EmbeddedDesign/VehicleAccessoryController/hardware/VehicleAccessoryController/img/IMG_5393.jpg

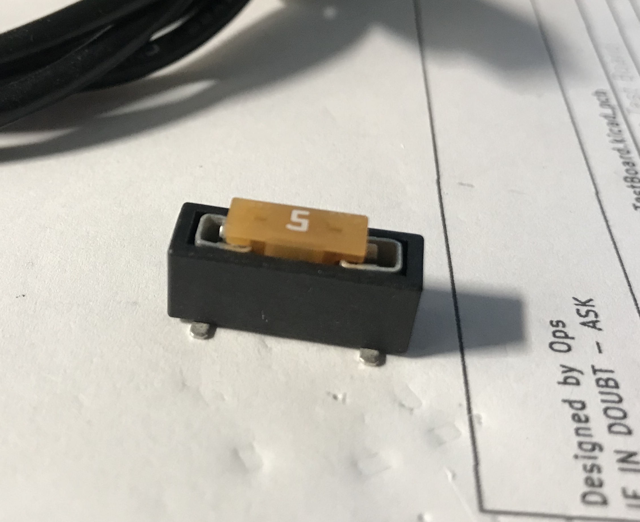
hardware/VehicleAccessoryController/img/IMG_5393.jpg
