EmbeddedDesign/VehicleAccessoryController/hardware/VehicleAccessoryController/img/VehicleAccessoryController_CAD.png

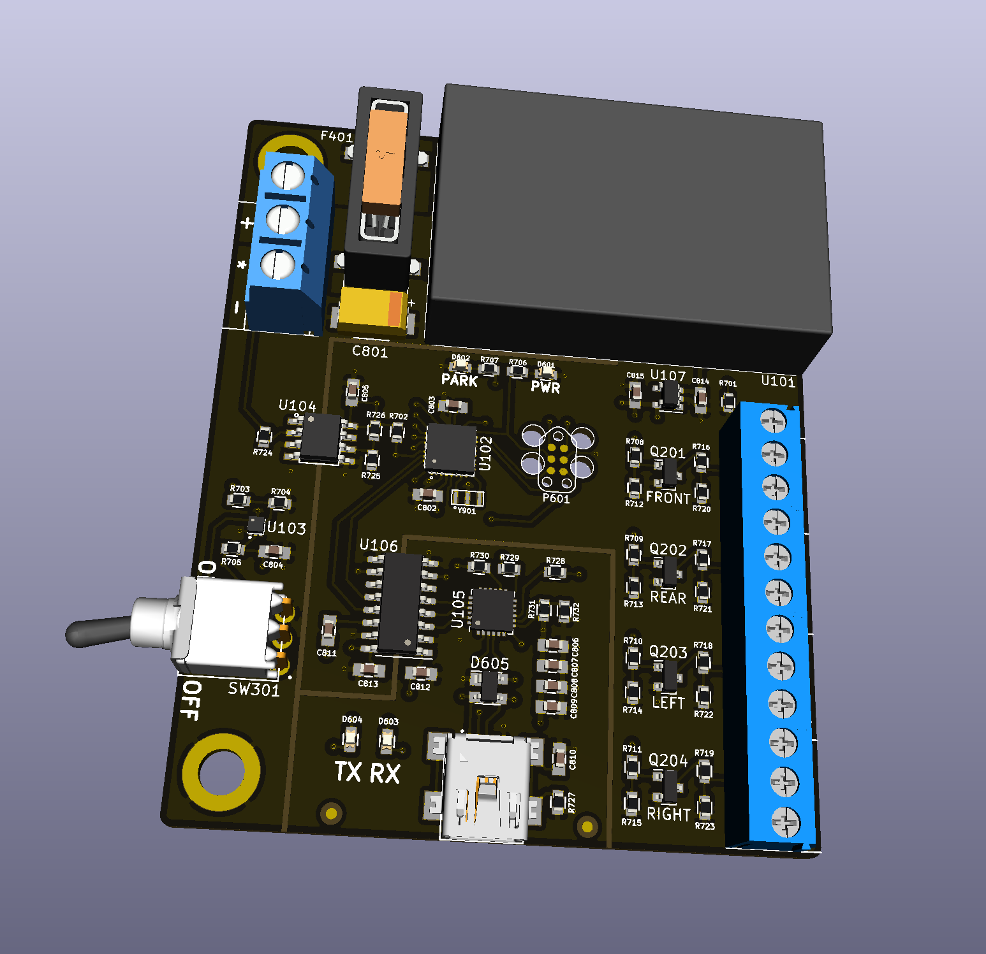
hardware/VehicleAccessoryController/img/VehicleAccessoryController_CAD.png
