EmbeddedDesign/VehicleAccessoryController/README.md

# VehicleAccessoryController
Vehicle Dash Cam and Accessory Controller
