EmbeddedDesign/VehicleAccessoryController/Garmin/IMG_5390.jpg

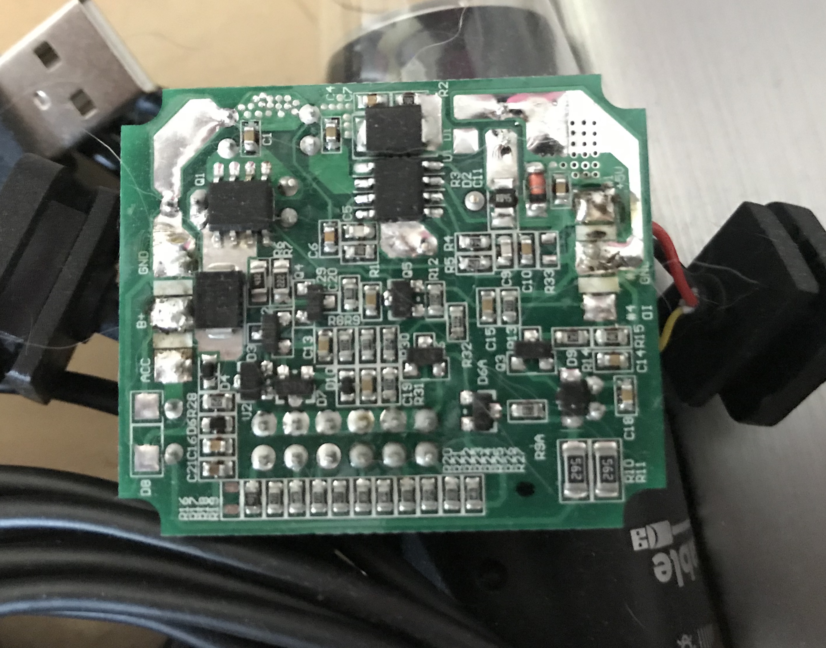
Garmin/IMG_5390.jpg
