EmbeddedDesign/VehicleAccessoryController/Garmin/IMG_5391.jpg

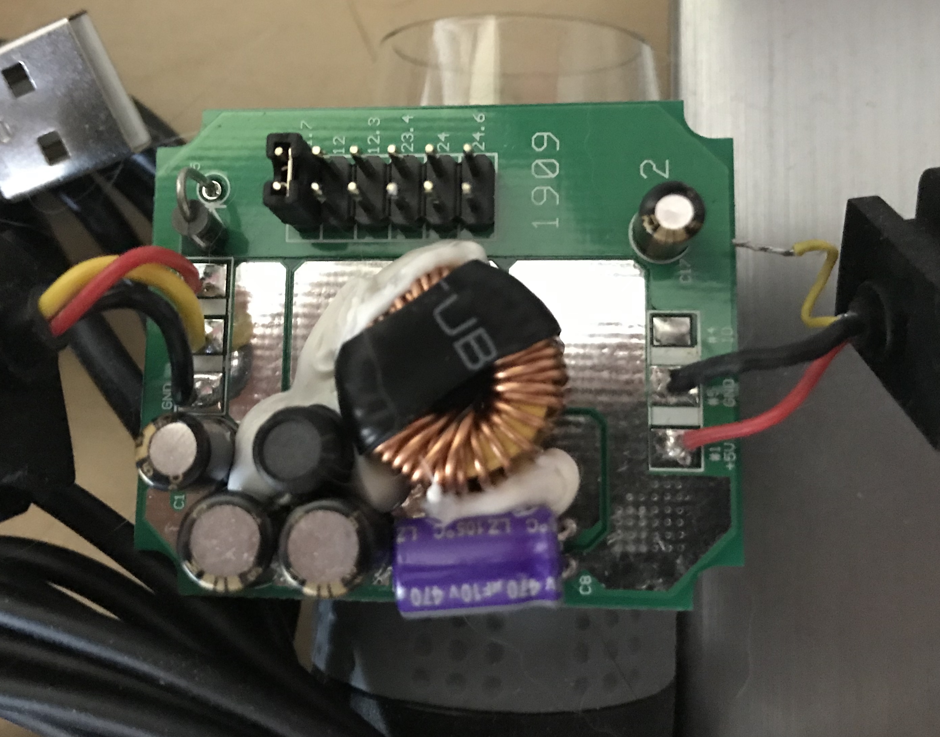
Garmin/IMG_5391.jpg
