EmbeddedDesign/VehicleAccessoryController/Garmin/Parking_Mode_IC1.jpg

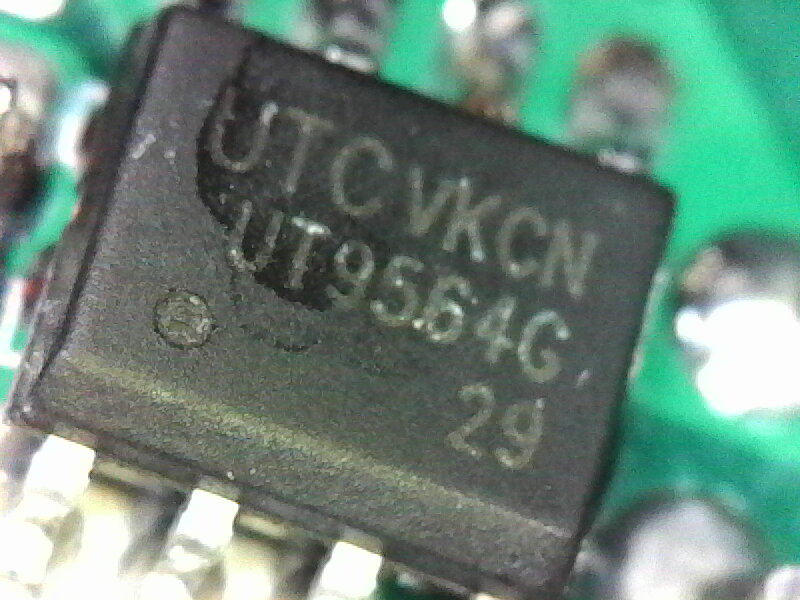
Garmin/Parking_Mode_IC1.jpg
