EmbeddedDesign/VehicleAccessoryController/Garmin/Parking_Mode_IC2.jpg

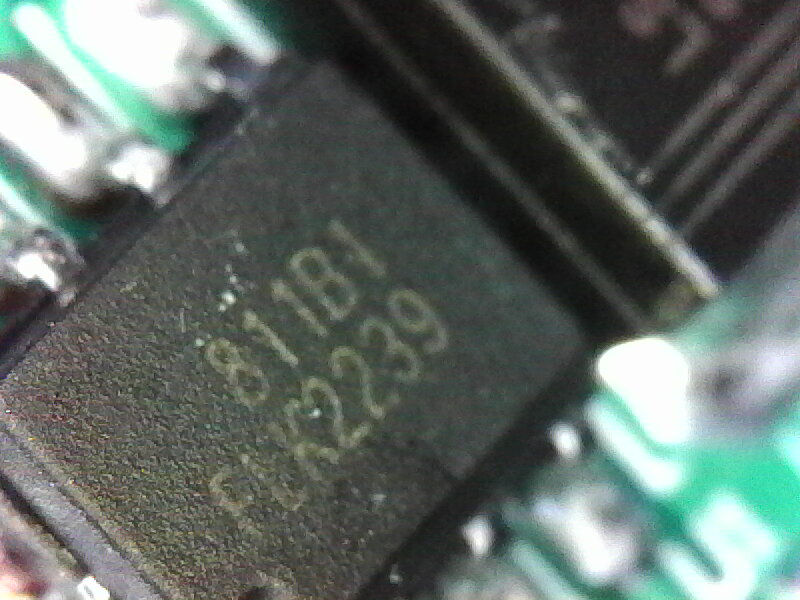
Garmin/Parking_Mode_IC2.jpg
