EmbeddedDesign/VehicleAccessoryController/Garmin/Parking_Mode_IDPIN1.jpg

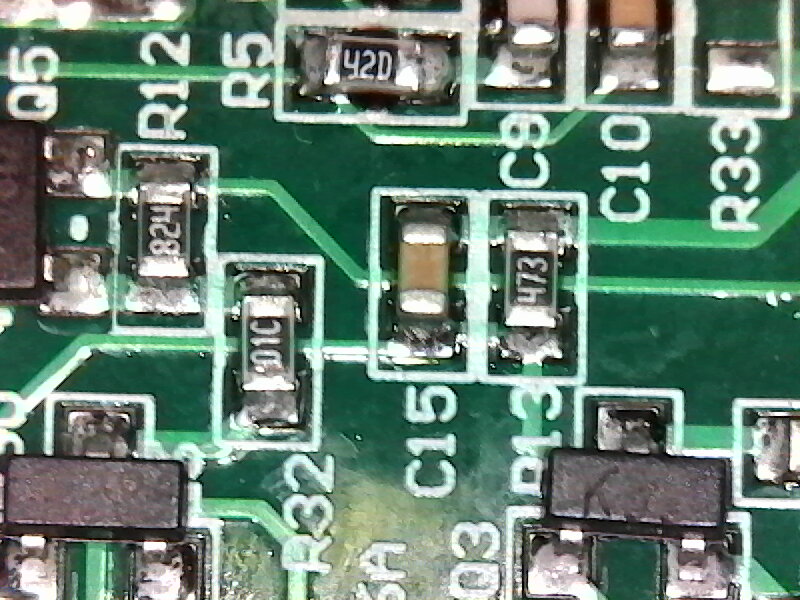
Garmin/Parking_Mode_IDPIN1.jpg
