EmbeddedDesign/VehicleAccessoryController/Garmin/Parking_Mode_IDPIN2.jpg

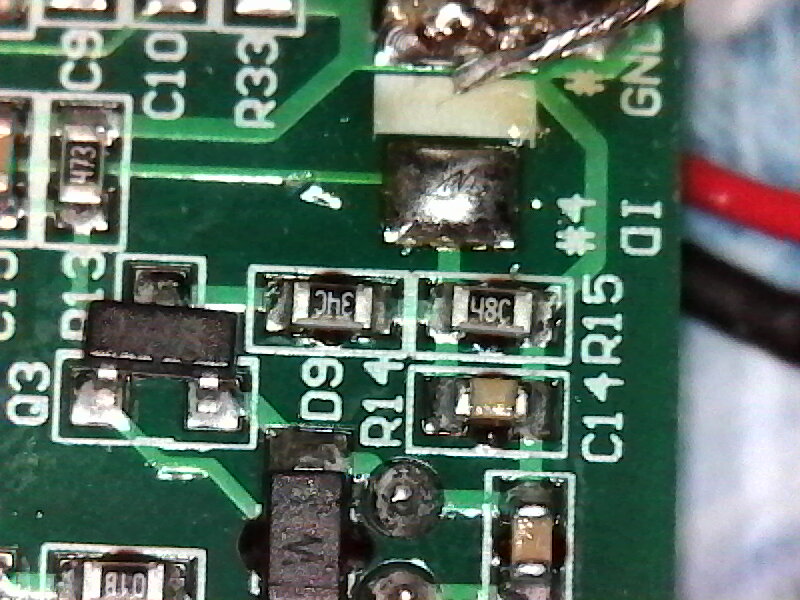
Garmin/Parking_Mode_IDPIN2.jpg
