EmbeddedDesign/VehicleAccessoryController/Garmin/XRAY_center.png

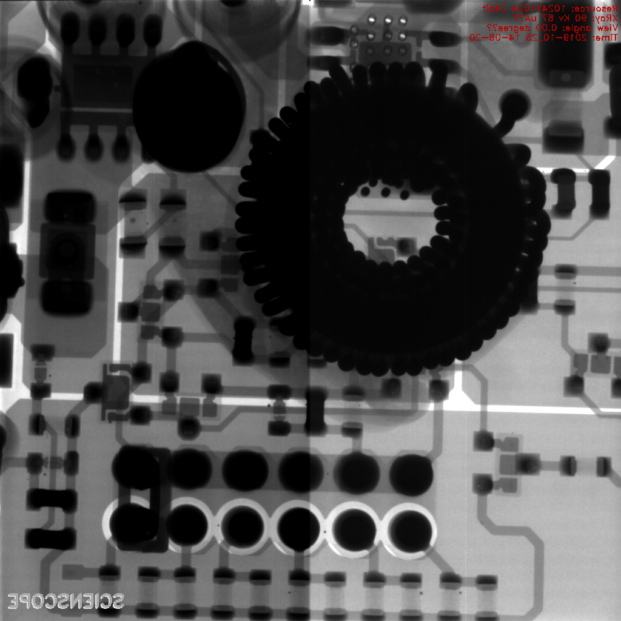
Garmin/XRAY_center.png
