EmbeddedDesign/VehicleAccessoryController/Garmin/XRAY_lower_left.png

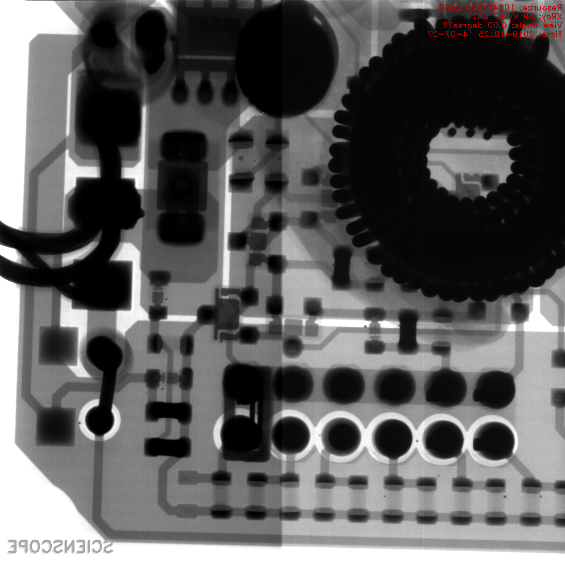
Garmin/XRAY_lower_left.png
