EmbeddedDesign/VehicleAccessoryController/Garmin/XRAY_lower_right.png

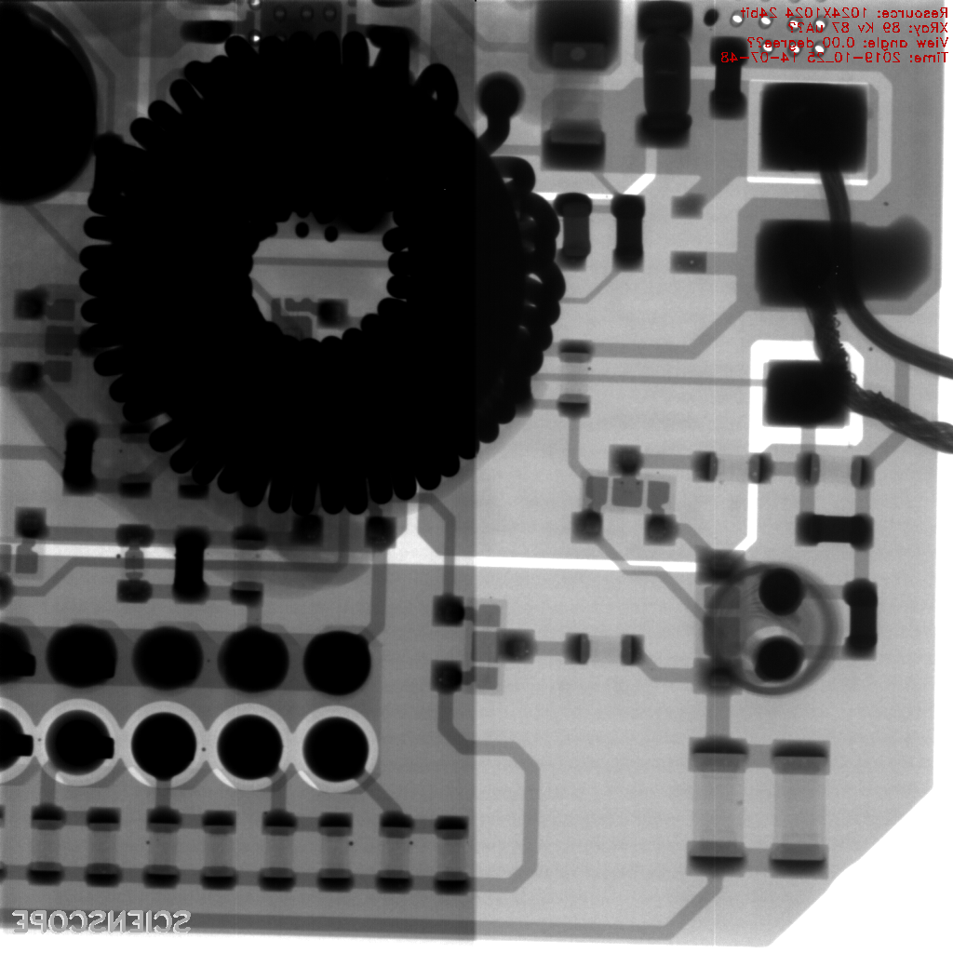
Garmin/XRAY_lower_right.png
