EmbeddedDesign/VehicleAccessoryController/Garmin/XRAY_upper_left.png

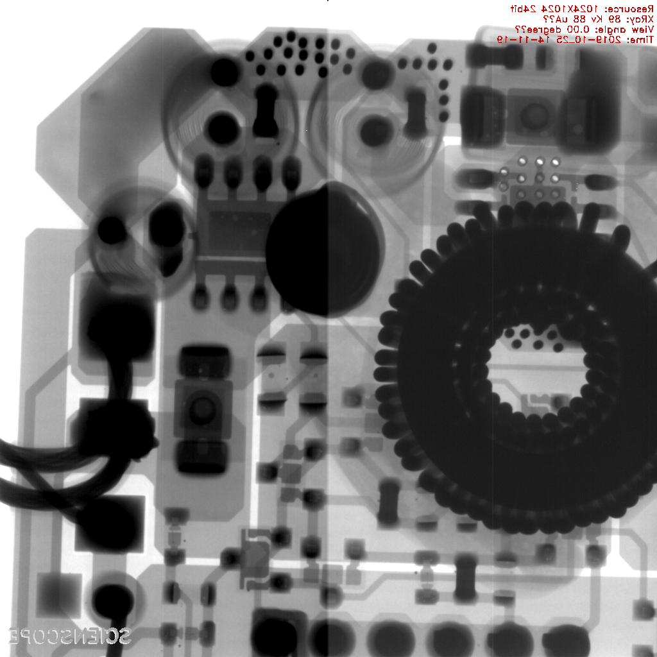
Garmin/XRAY_upper_left.png
