EmbeddedDesign/VehicleAccessoryController/Garmin/XRAY_upper_right.png

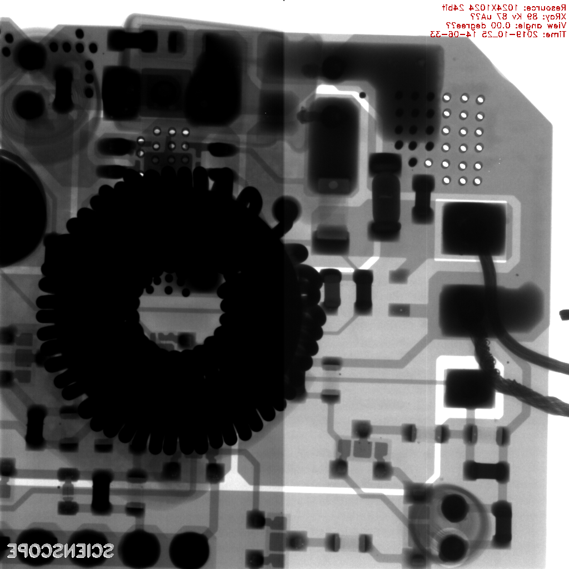
Garmin/XRAY_upper_right.png
