EmbeddedDesign/VehicleAccessoryController/hardware/VehicleAccessoryController/img/IMG_5392.jpg

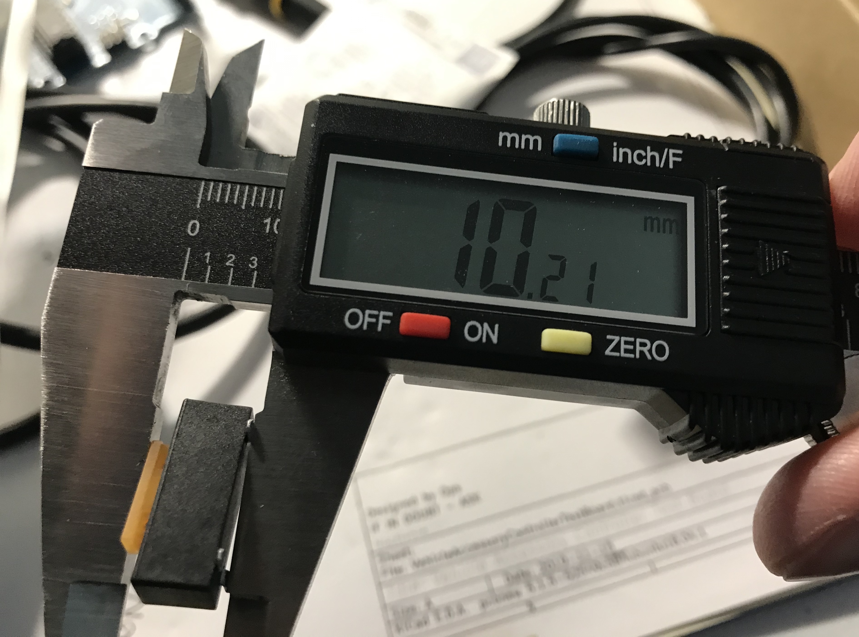
hardware/VehicleAccessoryController/img/IMG_5392.jpg
