EmbeddedDesign/VehicleAccessoryController/img/IMG_5389.jpg

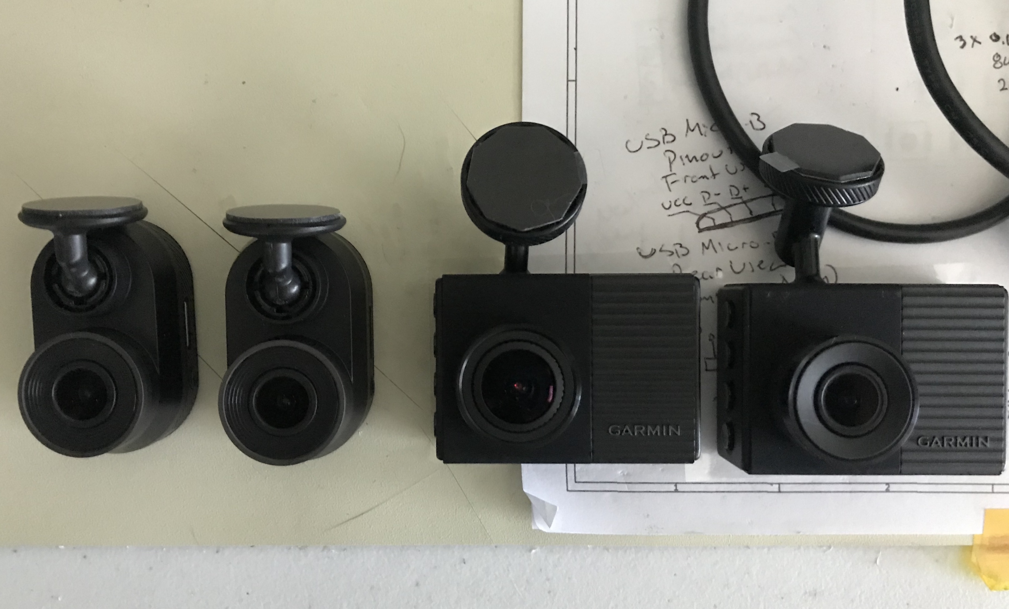
img/IMG_5389.jpg
