EmbeddedDesign/VehicleAccessoryController/hardware/VehicleAccessoryController/VehicleAccessoryController_BOM.ods

Sheet: Vehicle Accessory Controller PCBA
Vehicle Accessory Controller PCBA BOM v1.0
REF | QTY | Cost | MRF | MFRPN | DESCRIPTION | PACKAGE | DATASHEET | LINK | ALT
U101 | 1 | $78.25 | Recom | REM20-2405SW/P | Recom Power Module, Control Pin Positive Logic | Custom | https://recom-power.com/pdf/Medline_DC-DC/REM20-W.pdf | https://www.arrow.com/en/products/rem20-2405swp/recom-power
U102 | 1 | $2.24 | Atmel | ATMEGA328P-MNR | ATmega328P | 32-VQFN/MLF | http://ww1.microchip.com/downloads/en/DeviceDoc/ATmega48A-PA-88A-PA-168A-PA-328-P-DS-DS40002061A.pdf | https://www.arrow.com/en/products/atmega328p-mnr/microchip-technology
U103 | 1 | $1.66 | TI | TPS3710QDSERQ1 | Under-voltage Supervisor | WSON-6 | https://www.ti.com/lit/ds/symlink/tps3710-q1.pdf | https://www.arrow.com/en/products/tps3710qdserq1/texas-instruments
U104 | 1 | $0.79 | SiLabs | SI8710CC-B-IS | Single-Channel Digital Isolator | SOIC-8 NB | https://media.digikey.com/pdf/Data Sheets/Silicon Laboratories PDFs/Si87xx.pdf (https://media.digikey.com/pdf/Data%20Sheets/Silicon%20Laboratories%20PDFs/Si87xx.pdf) | https://www.arrow.com/en/products/si8710cc-b-is/silicon-labs
U105 | 1 | $1.33 | SiLabs | CP2102N-A02-GQFN24 | USB-to-UART Bridge | QFN24 | https://www.silabs.com/documents/public/data-sheets/cp2102n-datasheet.pdf | https://www.arrow.com/en/products/cp2102n-a02-gqfn24/silicon-labs
U106 | 1 | $2.58 | SiLabs | Si8631EC-B-IS1 | Tripple-Channel Digital Isolator, Default High | NB SOIC-16 | https://www.silabs.com/documents/public/data-sheets/si863x-datasheet.pdf | https://www.arrow.com/en/products/si8631ec-b-is1/silicon-labs
U107 | 1 | $0.58 | ON Semi | NCV551SN50T1G | LDO, 5V, 150mA | SOT-23-5 | https://www.onsemi.com/pub/Collateral/NCP551-D.PDF | https://www.arrow.com/en/products/ncv551sn50t1g/on-semiconductor
Y901 | 1 | $0.40 | Murata | CSTNE16M0VH3C000R0 | 16MHz Resonator, 0.13%, 15pF | 3 Pad Custom | https://www.murata.com/en/products/productdata/8801162264606/SPEC-CSTNE16M0VH3C000R0.pdf | https://www.arrow.com/en/products/cstne16m0vh3c000r0/murata-manufacturing
Q201, Q202, Q203, Q204 | 4 | $0.22 | ON Semi | BSS138 | N-Channel Logic-Level Enhancement Mode MOSFET | SOT-23-3 | https://www.onsemi.com/pub/Collateral/BSS138-D.PDF | https://www.arrow.com/en/products/bss138/on-semiconductor | Diodes BSN20-7
D601, D602, D603, D604 | 4 | $0.41 | OSRAM | LB Q39G-L2OO-35-1 | Indicator LED, Blue, 2.85Vf | Chip 0603 | https://media.digikey.com/pdf/Data Sheets/Osram PDFs/LB_Q39G_v1.4_9-1-15.pdf (https://media.digikey.com/pdf/Data%20Sheets/Osram%20PDFs/LB_Q39G_v1.4_9-1-15.pdf) | https://www.arrow.com/en/products/lbq39g-l2oo-35-1/osram-opto-semiconductors
D605 | 1 | $0.70 | Littelfuse | SP0503BAHT | 3-Channel TVS Diode Array | SOT143 | https://www.littelfuse.com/~/media/files/littelfuse/technical resources/documents/data sheets/sp05xxba.pdf | https://www.arrow.com/en/products/sp0503bahtg/littelfuse
SW301 | 1 | $6.74 | C&K | ET01MD1AGE | SPDT On-On Toggle Switch | Custom | https://www.ckswitches.com/products/toggle/ET/#ET01MD1AGE | https://www.arrow.com/en/products/et01md1age/ck | C&K ET01MD1ABE, C&K ET01M3D1ABE (Black ESD)
F401 | 1 | $1.53 | Keystone | 3587 | Low Profile MINI Fuse Holder | Custom | http://www.keyelco.com/product-pdf.cfm?p=310 | https://www.digikey.com/product-detail/en/keystone-electronics/3587/36-3587-ND/2137315 | 3587-10 (Red), 3587-15 (Blue), 3587-20 (Yellow)
J501 | 1 | $1.16 | Keystone | 8719 | 1x3 Screw Terminal 14-22 AWG | Custom | https://www.keyelco.com/userAssets/file/M55p58.pdf | https://www.digikey.com/product-detail/en/keystone-electronics/8719/36-8719-ND/317125
J502, J503, J504, J505 | 4 | $1.01 | TE | 1776275-3 | 1x3 Screw Terminal 18-26 AWG | Custom | https://www.te.com/commerce/DocumentDelivery/DDEController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 | https://www.arrow.com/en/products/1776275-3/te-connectivity
J506 | 1 | $0.77 | AFCI | 10033526-N3212LF | USB-mini Connector | Custom | https://www.amphenol-icc.com/media/wysiwyg/files/drawing/10033526.pdf | https://www.arrow.com/en/products/10033526-n3212lf/amphenol-fci | 10033526-N3212MLF, 10033526-N3222LF, 10033526-N3222MLF
R701 | 1 | $0.33 | Panasonic | ERA-3AEB4872V | 48.7K Ohm Resistor, +/-1%, 1/16W or greater | 0603 | https://industrial.panasonic.com/cdbs/www-data/pdf/RDM0000/AOA0000C307.pdf | https://www.arrow.com/en/products/era-3aeb4872v/panasonic
R702 | 1 | $0.65 | Panasonic | ERA-3APB103V | 10K Ohm Resistor, +/-5%, 0.1W | 0603 | https://industrial.panasonic.com/cdbs/www-data/pdf/RDM0000/AOA0000C307.pdf | https://www.arrow.com/en/products/era-3apb103v/panasonic
R703 | 1 | $0.10 | Yageo | RC0603FR-072M43L | 2.43M Ohm Resistor, +/-0.5%, 0.1W | 0603 | https://static6.arrow.com/aropdfconversion/ab27cab4c33d97da38ecc8ac38e34caed1b4f994/rc0603fr-07956kl.pdf | https://www.arrow.com/en/products/rc0603fr-072m43l/yageo
R704 | 1 | $0.33 | Panasonic | ERA-3AEB8452V | 84.5K Ohm Resistor, +/-0.5%, 0.1W | 0603 | https://industrial.panasonic.com/cdbs/www-data/pdf/RDM0000/AOA0000C307.pdf | https://www.arrow.com/en/products/era-3aeb8452v/panasonic
R705 | 1 | $0.54 | Panasonic | ERA-3ARB4992V | 49.9K Ohm Resistor, +/-0.5%, 0.1W | 0603 | https://industrial.panasonic.com/cdbs/www-data/pdf/RDM0000/AOA0000C307.pdf | https://www.arrow.com/en/products/era-3arb4992v/panasonic
R706, R707 | 2 | $0.33 | Panasonic | ERA-3AEB431V | 430 Ohm Led Resistor, +/-5%, 0.1W | 0603 | https://industrial.panasonic.com/cdbs/www-data/pdf/RDM0000/AOA0000C307.pdf | https://www.arrow.com/en/products/era3aeb431v/panasonic
R725 | 1 | $0.33 | Panasonic | ERA-3AED161V | 160 Ohm Resistor, +/-5%, 0.1W | 0603 | https://industrial.panasonic.com/cdbs/www-data/pdf/RDM0000/AOA0000C307.pdf | https://www.arrow.com/en/products/era-3aeb161v/panasonic
R708, R709, R710, R711, R724, R726, R728 | 7 | $0.54 | Panasonic | ERA-3ARB102V | 1K Ohm Resistor, +/-5%, 0.1W | 0603 | https://industrial.panasonic.com/cdbs/www-data/pdf/RDM0000/AOA0000C307.pdf | https://www.arrow.com/en/products/search?cat=&q=ERA-3ARB102V&r=true
R712, R713, R714, R715, R727 | 5 | $0.14 | Panasonic | ERJ-PA3F1004V | 1M Ohm Resistor, +/-5%, 0.1W | 0603 | https://industrial.panasonic.com/cdbs/www-data/pdf/RDO0000/AOA0000C331.pdf | https://www.arrow.com/en/products/erj-pa3f1004v/panasonic
R716, R717, R718, R719, R731 | 5 | $0.33 | Panasonic | ERA-3AEB2212V | 22.1K Ohm Resistor, +/-1%, 0.1W | 0603 | https://industrial.panasonic.com/cdbs/www-data/pdf/RDM0000/AOA0000C307.pdf | https://www.arrow.com/en/products/era-3aeb2212v/panasonic
R720, R721, R722, R723 | 4 | $0.33 | Panasonic | ERA-3AEB3092V | 30.9K Ohm Resistor, +/-1%, 0.1W | 0603 | https://industrial.panasonic.com/cdbs/www-data/pdf/RDM0000/AOA0000C307.pdf | https://www.arrow.com/en/products/era-3aeb3092v/panasonic
R729, R730 | 2 | $0.33 | Panasonic | ERA-3AEB90R9V | 90.9 Ohm Led Resistor, +/-5%, 0.1W | 0603 | https://industrial.panasonic.com/cdbs/www-data/pdf/RDM0000/AOA0000C307.pdf | https://www.arrow.com/en/products/era-3aeb90r9v/panasonic
R732 | 1 | $0.33 | Panasonic | ERA-3AEB4752V | 47.5K Ohm Resistor, +/-1%, 0.1W | 0603 | https://industrial.panasonic.com/cdbs/www-data/pdf/RDM0000/AOA0000C307.pdf | https://www.arrow.com/en/products/era3aeb4752v/panasonic
C801 | 1 | $2.79 | Kemet | T498D106K050ATE1K0 | 10uF Capacitor, +/-10%, 50V, X7R | 2917 | https://content.kemet.com/datasheets/KEM_T2053_T498_AUTO.pdf | https://www.arrow.com/en/products/t498d106k050ate1k0/kemet-corporation
C802, C814, C815 | 3 | $0.27 | Murata | GCJ188R71E105KA01D | 1uF Capacitor, +/-10%, 16V, X7R | 0603 | https://search.murata.co.jp/Ceramy/image/img/A01X/G101/ENG/GCJ188R71E105KA01-01.pdf | https://www.arrow.com/en/products/gcj188r71e105ka01d/murata-manufacturing
C803, C804, C805, C807, C809, C811, C812, C813 | 8 | $0.09 | Murata | GCJ188R71E104KA12D | 0.1uF Capacitor, +/-10%, 16V, X7R | 0603 | https://search.murata.co.jp/Ceramy/image/img/A01X/G101/ENG/GCJ188R71E104KA12-01.pdf | https://www.arrow.com/en/products/gcj188r71e104ka12d/murata-manufacturing
C806, C808 | 2 | $0.38 | Murata | GRM188C71C475KE21D | 4.7uF Capacitor, +/-10%, 16V, X7R | 0603 | https://search.murata.co.jp/Ceramy/image/img/A01X/G101/ENG/GRM188C71C475KE21-01.pdf | https://www.arrow.com/en/products/grm188c71c475ke21d/murata-manufacturing
C810 | 1 | $0.28 | Kemet | C0603C101K4RACAUTO | 0.1nF Capacitor, +/-10%, 16V, X7R | 0603 | https://content.kemet.com/datasheets/KEM_C1023_X7R_AUTO_SMD.pdf | https://www.arrow.com/en/products/c0603c101k4racauto/kemet-corporation
 | Cost/Board: | $122.03

Sheet: Other
Vehicle Accessory Controller Other v1.0
QTY | Cost | MRF | MFRPN | DESCRIPTION | DATASHEET | LINK | ALT
1 | $0.36 | C&K | 706202000 | Toggle Switch Cap | https://www.ckswitches.com/products/toggle/ET/ | https://www.arrow.com/en/products/706202000/ck
4 | $0.95 | Adafruit | 1826 | Micro USB Connector Solderable | https://media.digikey.com/pdf/Data Sheets/Adafruit PDFs/1826_Web.pdf (https://media.digikey.com/pdf/Data%20Sheets/Adafruit%20PDFs/1826_Web.pdf) | https://www.arrow.com/en/products/1826/adafruit-industries
1 | $0.37 | Littelfuse | 0891005.NXS | Low Profile MINI Blade Fuse, 5A, Tan | https://www.littelfuse.com/~/media/automotive/datasheets/fuses/passenger-car-and-commercial-vehicle/blade-fuses/littelfuse_lowprofilemini_datasheet.pdf | https://www.digikey.com/products/en?keywords= 0891005.NXS | 0891005.H, 0891005.U
1 | $0.37 | Littelfuse | 0891002.NXS | Low Profile MINI Blade Fuse, 2A, Gray | https://www.littelfuse.com/~/media/automotive/datasheets/fuses/passenger-car-and-commercial-vehicle/blade-fuses/littelfuse_lowprofilemini_datasheet.pdf | https://www.digikey.com/product-detail/en/littelfuse-inc/0891002-NXS/F5926-ND/2046664
1 | $0.80 | Littelfuse | 00970021HXNVDL | Fuse Puller | https://www.littelfuse.com/~/media/automotive/datasheets/fuse-pullers/littelfuse_fuse_puller_tester.pdf | https://www.digikey.com/product-detail/en/littelfuse-inc/00970021HXNVDL/F6036-ND/3425337
1 | $117.80 | Tensility | 30-00496 | 3 Conductor 26 AWG Cable | https://tensility.s3.amazonaws.com/uploads/pdffiles/30-00496.pdf?X-Amz-Expires=600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 | https://www.digikey.com/products/en/cables-wires/multiple-conductor-cables/473?k=30-00496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
1 | $15.20 | Remington | 16STRBLAGXL25 | 1 Conductor, 16AWG, Automotive Cable, Black | https://media.digikey.com/pdf/Data Sheets/RemingtonInd/GXL_Hook_Up_Wire_DataSheet.pdf (https://media.digikey.com/pdf/Data%20Sheets/RemingtonInd/GXL_Hook_Up_Wire_DataSheet.pdf) | https://www.digikey.com/product-detail/en/remington-industries/16STRBLAGXL25/2328-16STRBLAGXL25-ND/12318330
1 | $15.20 | Remington | 16STRREDGXL25 | 1 Conductor, 16AWG, Automotive Cable, Red | https://media.digikey.com/pdf/Data Sheets/RemingtonInd/GXL_Hook_Up_Wire_DataSheet.pdf (https://media.digikey.com/pdf/Data%20Sheets/RemingtonInd/GXL_Hook_Up_Wire_DataSheet.pdf) | https://www.digikey.com/product-detail/en/remington-industries/16STRREDGXL25/2328-16STRREDGXL25-ND/12318290
1 | $5.42 | Kemet | EFW(005)-80X80T0800 | RF EMI Absorbing Sheet, 80mm x 80mm | https://content.kemet.com/datasheets/KEM_FS8004_NSS.pdf | https://www.digikey.com/product-detail/en/kemet/EFW-005-80X80T0800/399-EFW-005-80X80T0800-ND/11503822
1 | $0.35 | TE | 320560 | Ring Terminal, 14-16 AWG, #8 Stud | https://www.te.com/commerce/DocumentDelivery/DDEController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 | https://www.digikey.com/product-detail/en/te-connectivity-amp-connectors/320560/A27256-ND/299296
Cost/Board: | $159.67
