EmbeddedDesign/VehicleAccessoryController/hardware/VehicleAccessoryControllerTestBoard/img/IMG_5388.jpg

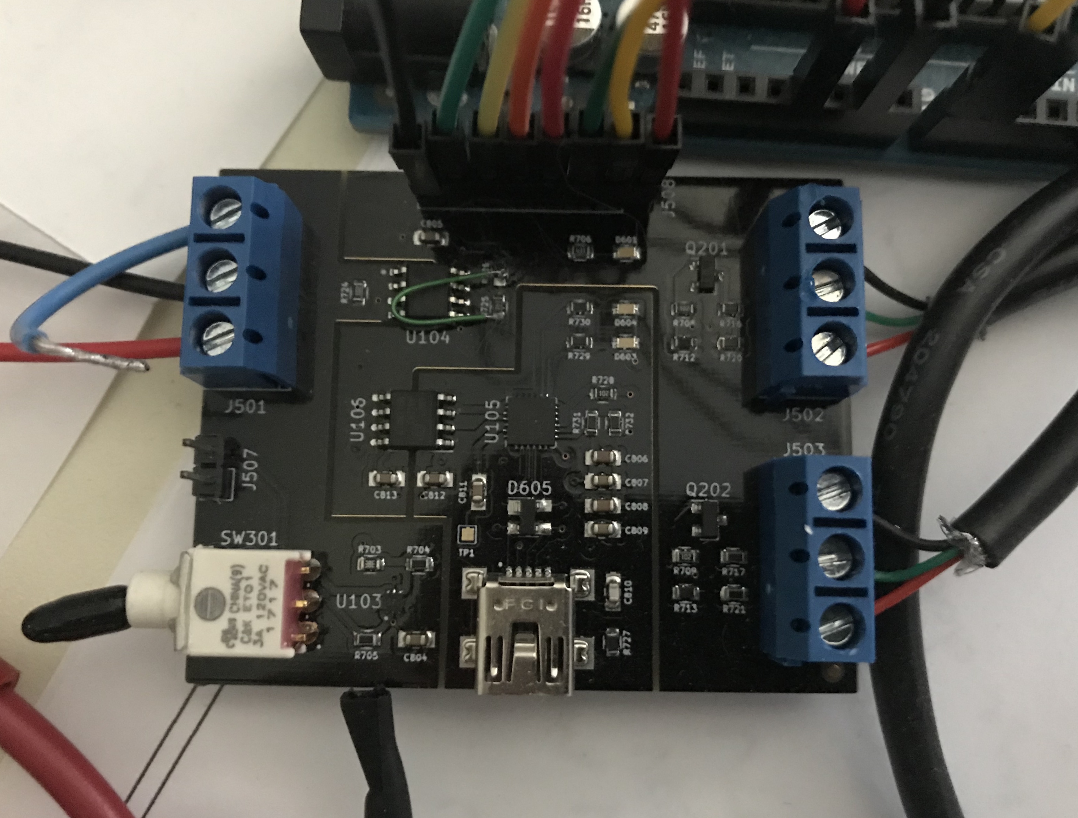
hardware/VehicleAccessoryControllerTestBoard/img/IMG_5388.jpg
