EmbeddedDesign/VehicleAccessoryController/hardware/VehicleAccessoryController/VehicleAccessoryController_schematic.pdf

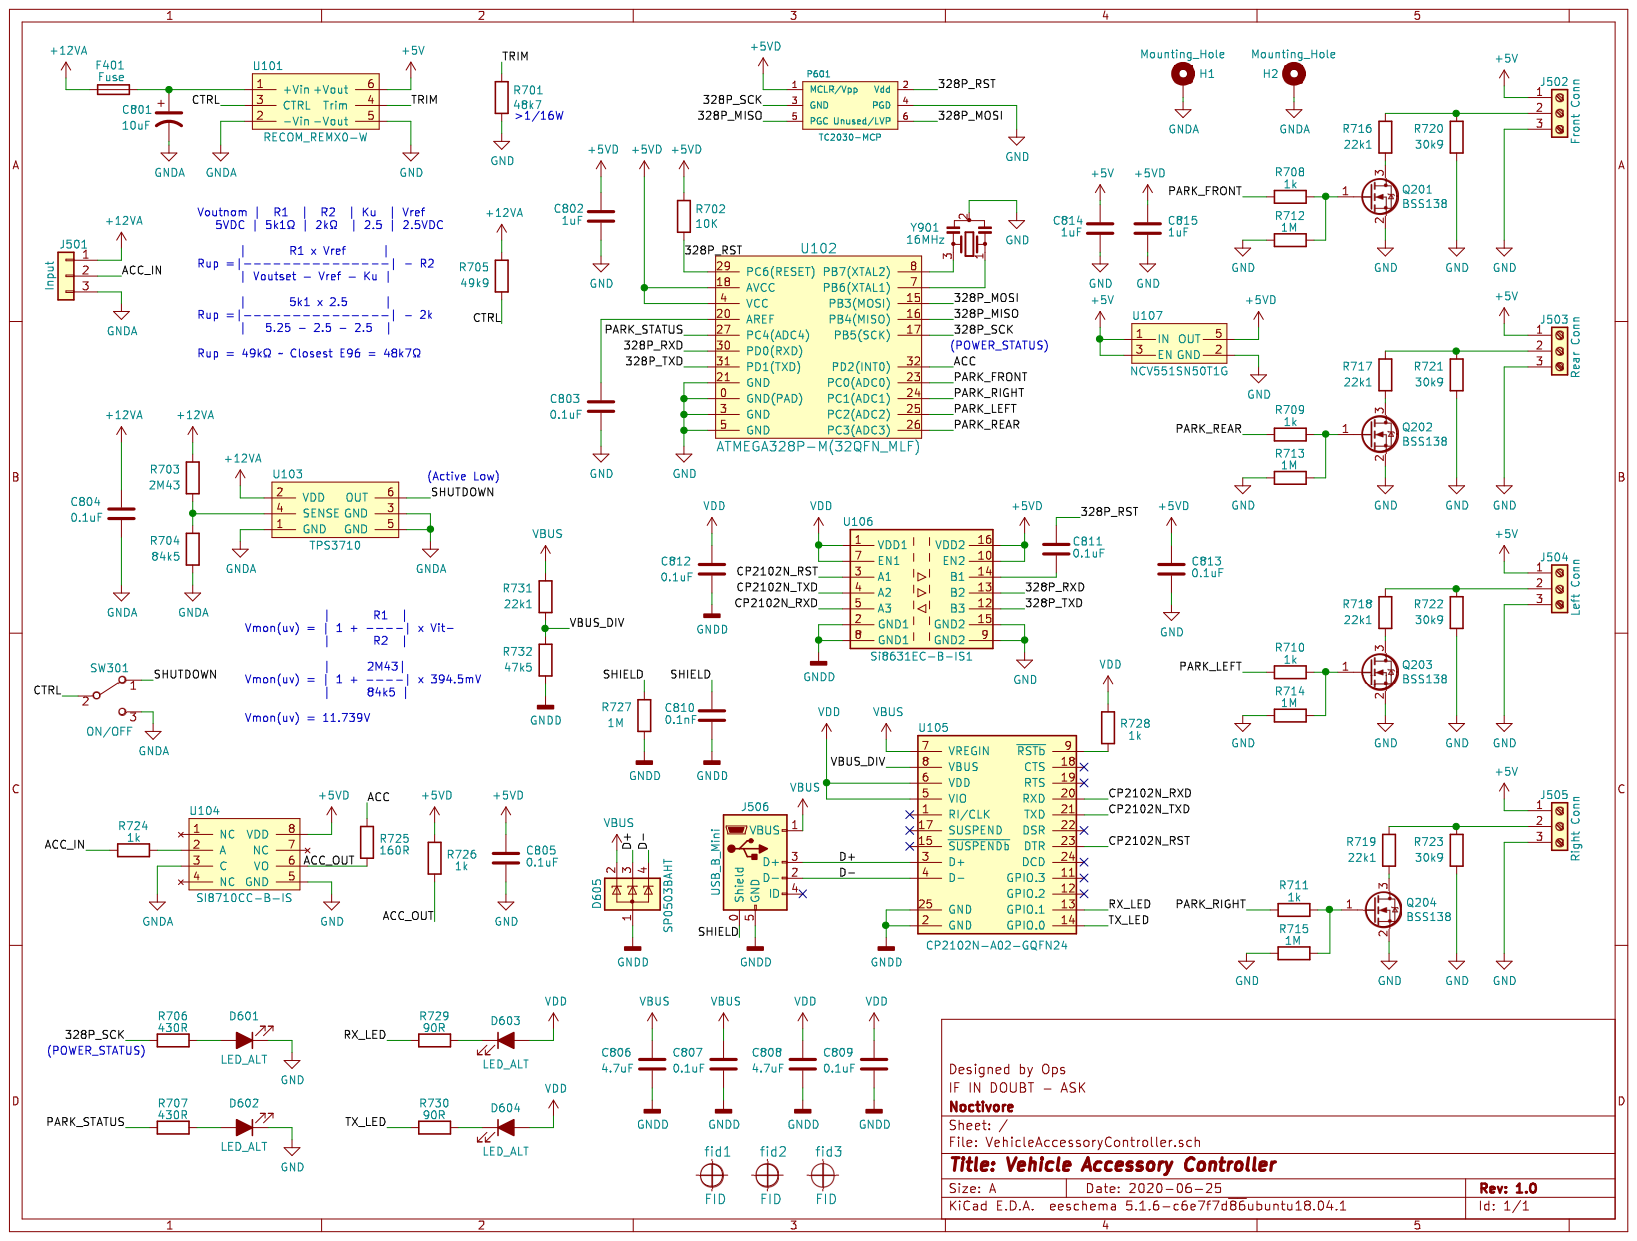
[picture p17: page 1]
