EmbeddedDesign/VehicleAccessoryController/hardware/VehicleAccessoryController/VehicleAccessoryController_layout.pdf

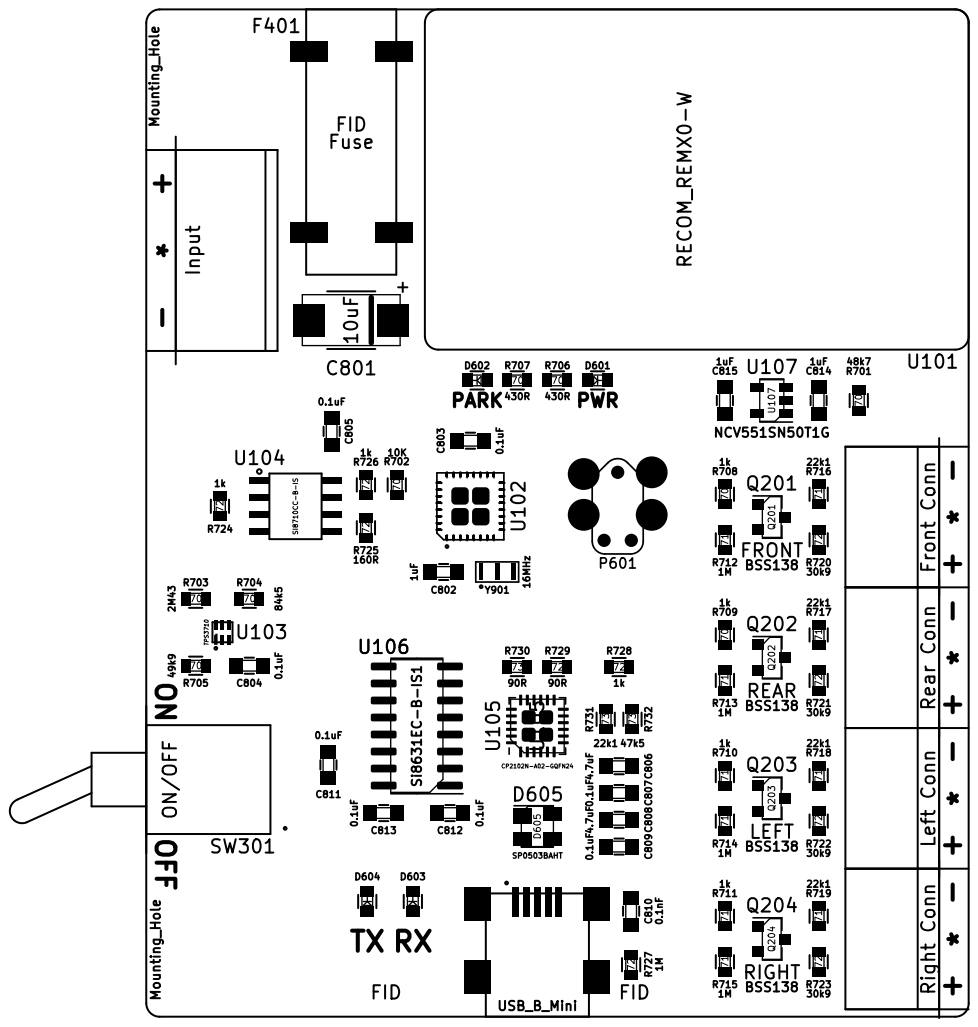
[picture p18: page 1]
