EmbeddedDesign/VehicleAccessoryController/hardware/VehicleAccessoryControllerTestBoard/VehicleAccessoryControllerTestBoard_Layout.pdf

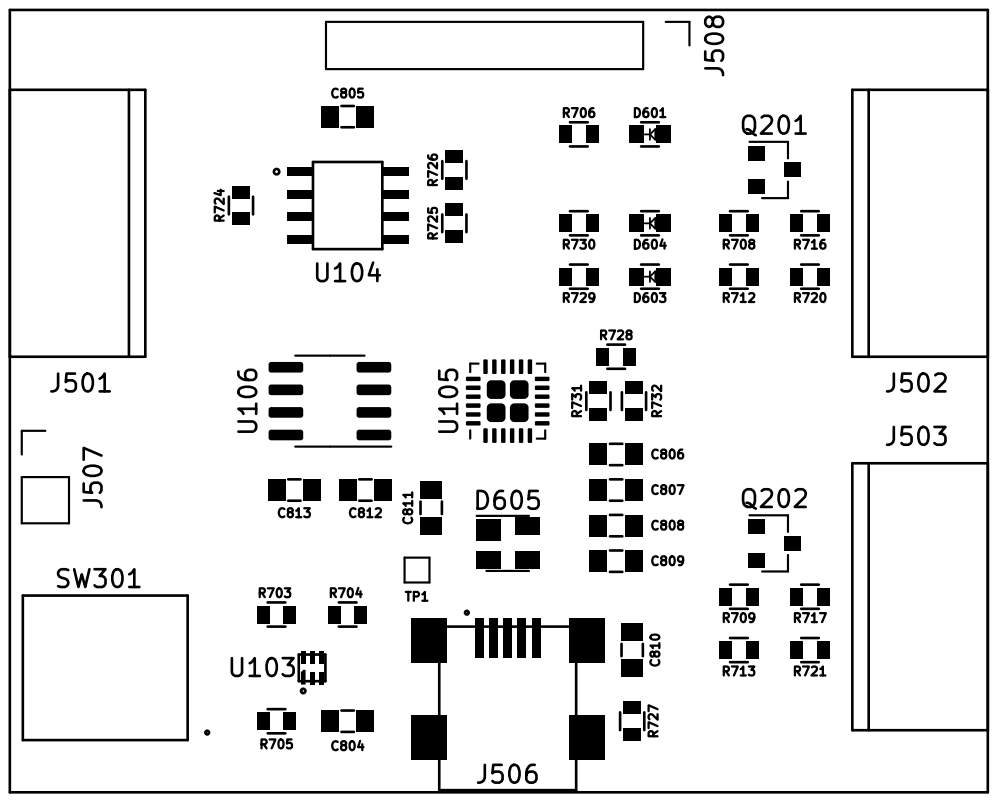
[picture p19: page 1]
