EmbeddedDesign/VehicleAccessoryController/hardware/VehicleAccessoryControllerTestBoard/VehicleAccessoryControllerTestBoard_Schematic.pdf

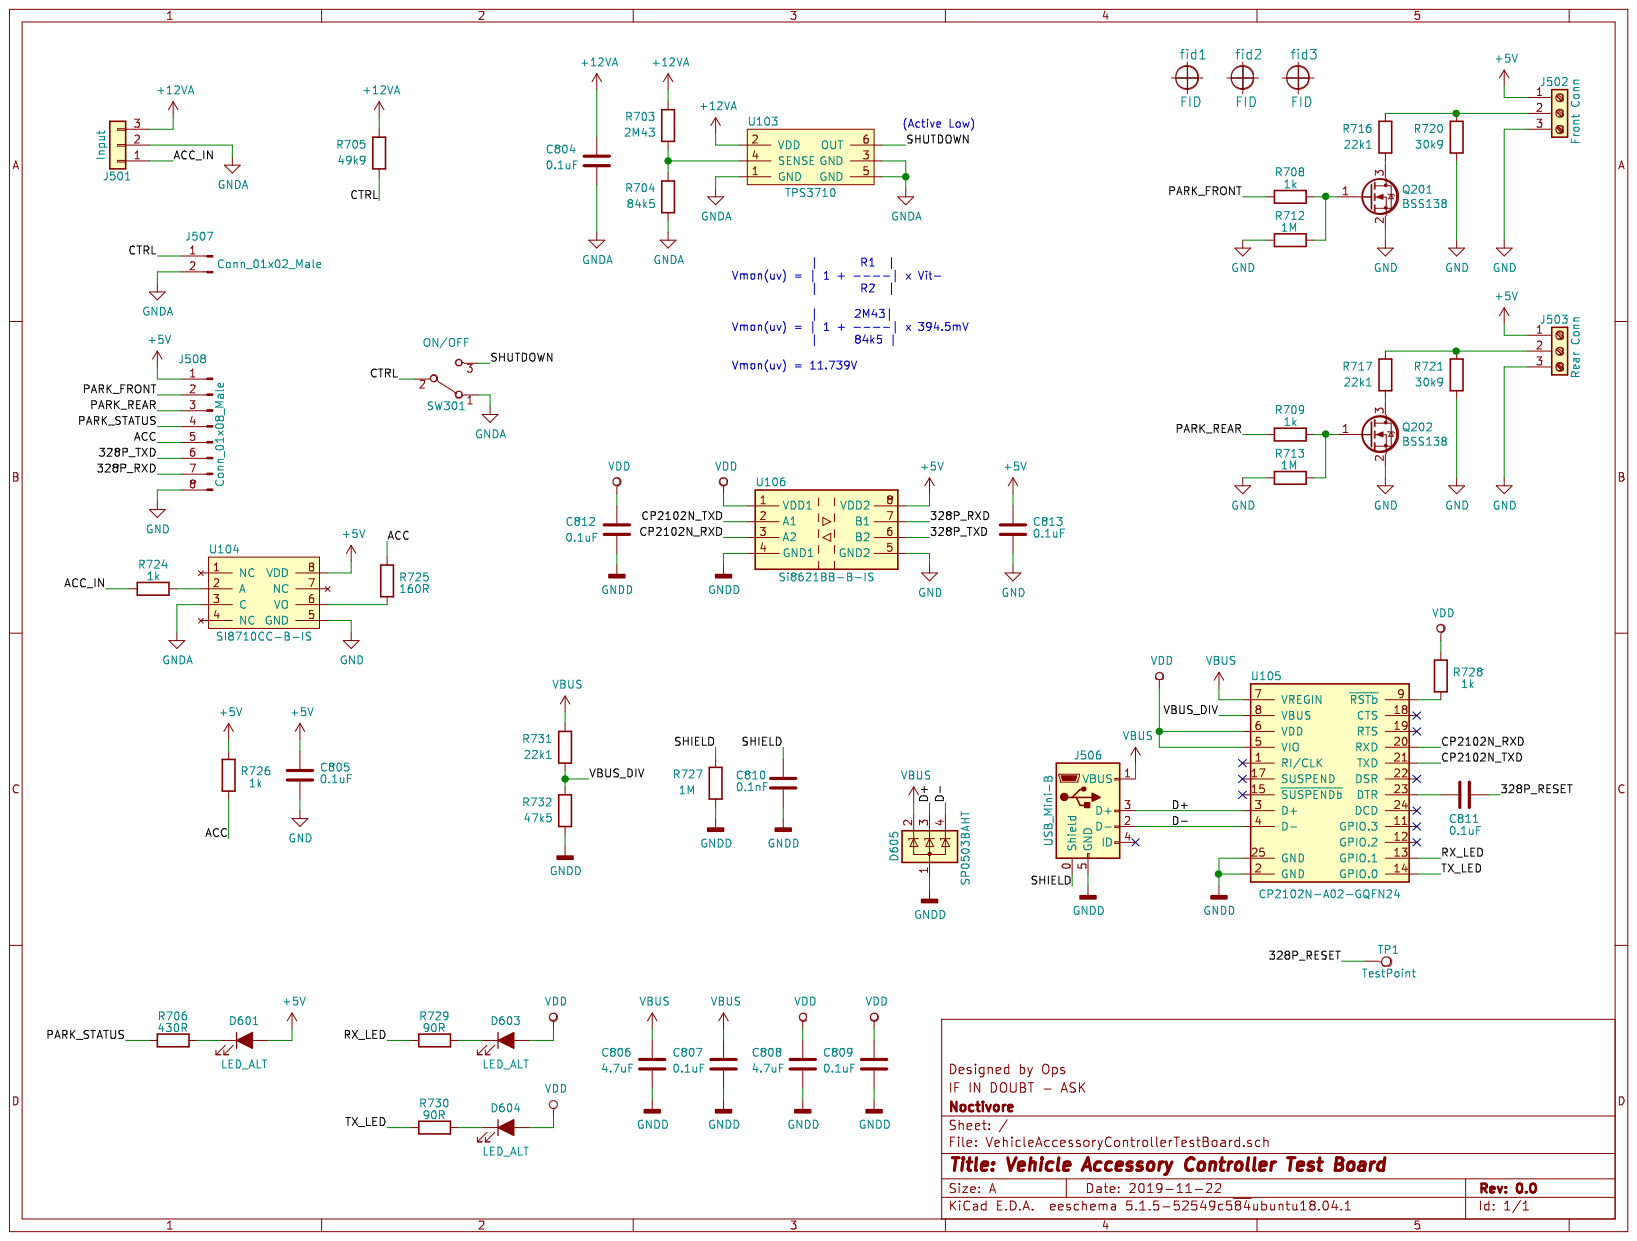
[picture p20: page 1]
