EmbeddedDesign/VehicleAccessoryController/hardware/VehicleAccessoryController/VehicleAccessoryController.kicad_pcb

## KiCad design hardware/VehicleAccessoryController/VehicleAccessoryController.kicad_pcb (2020-07-04)

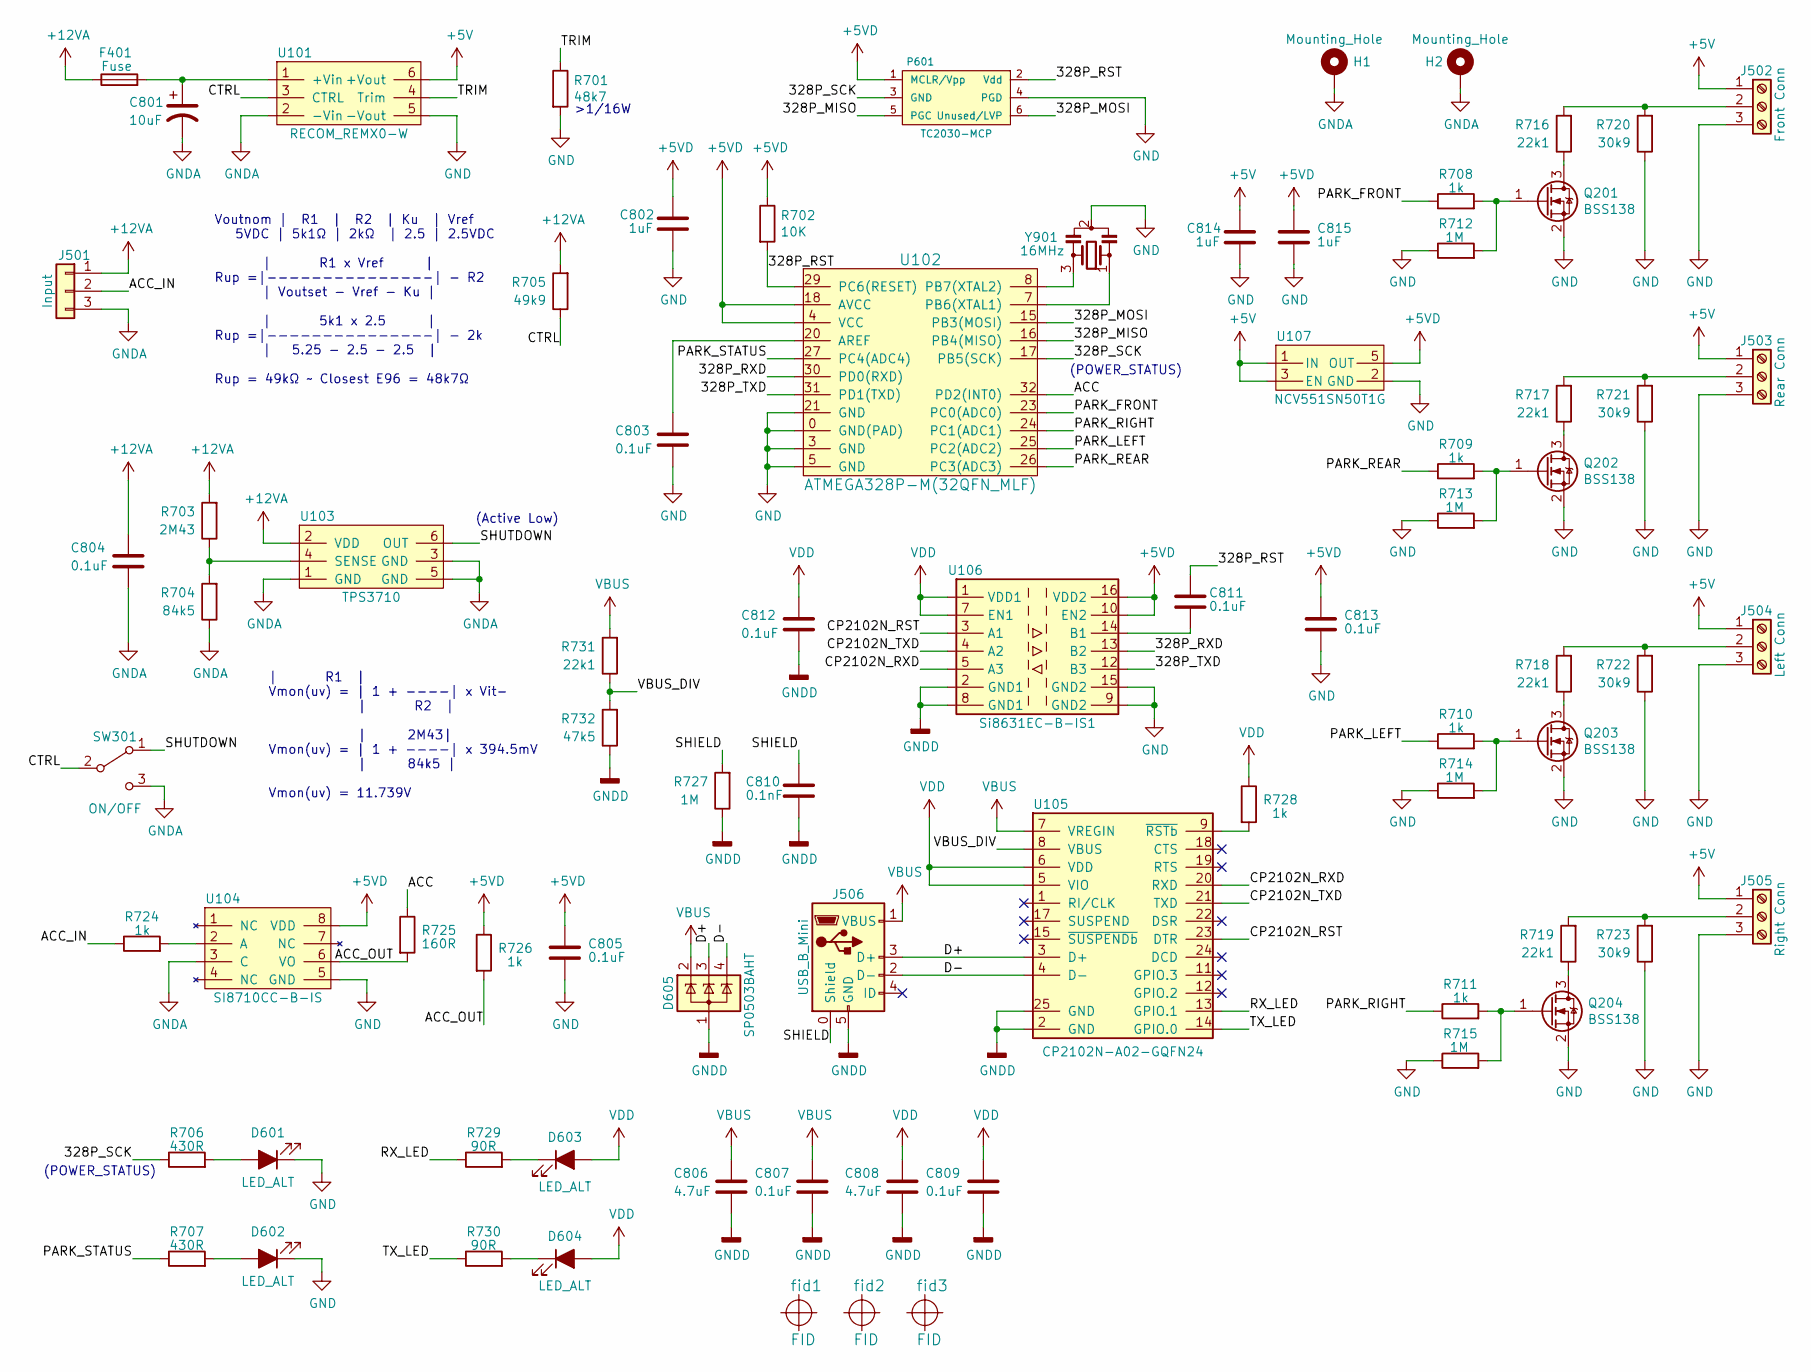
[picture p21: schematic VehicleAccessoryController.sch, Vehicle Accessory Controller]

Parts:
C801: 10uF; C_2917_D
C802, C814, C815: 1uF; C_0603
C803, C804, C805, C807, C809, C811, C812, C813: 0.1uF; C_0603
C806, C808: 4.7uF; C_0603
C810: 0.1nF; C_0603
D601, D602, D603, D604: LED_ALT; LED_0603
D605: SP0503BAHT; SOT-143
F401: Fuse; Keystone_3587
H1, H2: Mounting_Hole
J501: Input; Keystone_8719
J502: Front Conn; TE_1776275-3
J503: Rear Conn; TE_1776275-3
J504: Left Conn; TE_1776275-3
J505: Right Conn; TE_1776275-3
J506: USB_B_Mini; AFCI_10033526_USB-mini
P601: TC2030-MCP; TC2030_SMALL
Q201, Q202, Q203, Q204: BSS138; SOT-23
R701: 48k7; R_0603
R702: 10K; R_0603
R703: 2M43; R_0603
R704: 84k5; R_0603
R705: 49k9; R_0603
R706, R707: 430R; R_0603
R708, R709, R710, R711, R724, R726, R728: 1k; R_0603
R712, R713, R714, R715, R727: 1M; R_0603
R716, R717, R718, R719, R731: 22k1; R_0603
R720, R721, R722, R723: 30k9; R_0603
R725: 160R; R_0603
R729, R730: 90R; R_0603
R732: 47k5; R_0603
SW301: ON/OFF; C&K_ET_Series_Switch
U101: RECOM_REMX0-W; REM20-XXXXXW
U102: ATMEGA328P-M(32QFN_MLF); ATMEGA328P-MU_VQFN_MLF32
U103: TPS3710; TI_DSE_(S-PWSON-N6)
U104: SI8710CC-B-IS; SOIC-8_NB
U105: CP2102N-A02-GQFN24; QFN-24-1EP_4x4mm_P0.5mm_EP2.6x2.6mm
U106: Si8631EC-B-IS1; SOIC-16_3.9x9.9mm_P1.27mm
U107: NCV551SN50T1G; SOT-23-5
Y901: 16MHz; CSTNE_Resonator
fid1, fid2, fid3: FID; Fiducial

Connections:
+5V: C814.1, J502.1, J503.1, J504.1, J505.1, U101.6 (+Vout), U107.1 (IN), U107.3 (EN)
+5VD: C802.1, C805.1, C813.1, C815.1, P601.1 (MCLR/Vpp), R702.1, R726.1, U102.4 (VCC), U102.18 (AVCC), U104.8 (VDD), U106.10 (EN2), U106.16 (VDD2), U107.5 (OUT)
+12VA: C804.1, F401.1, J501.1, R703.2, R705.2, U103.2 (VDD)
/328P_MISO: P601.5 (PGC), U102.16 (PB4(MISO))
/328P_MOSI: P601.6 (Unused/LVP), U102.15 (PB3(MOSI))
/328P_RST: C811.1, P601.2 (Vdd), R702.2, U102.29 (PC6(RESET))
/328P_RXD: U102.30 (PD0(RXD)), U106.13 (B2)
/328P_SCK: P601.3 (GND), R706.1, U102.17 (PB5(SCK))
/328P_TXD: U102.31 (PD1(TXD)), U106.12 (B3)
/ACC: R725.1, U102.32 (PD2(INT0))
/ACC_IN: J501.2, R724.1
/ACC_OUT: R725.2, R726.2, U104.6 (VO)
/CP2102N_RST: U105.23 (DTR), U106.3 (A1)
/CP2102N_RXD: U105.20 (RXD), U106.5 (A3)
/CP2102N_TXD: U105.21 (TXD), U106.4 (A2)
/CTRL: R705.1, SW301.2 (B), U101.3 (CTRL)
/D+: D605.3 (K), J506.3 (D+), U105.3 (D+)
/D-: D605.4 (K), J506.2 (D-), U105.4 (D-)
/PARK_FRONT: R708.1, U102.23 (PC0(ADC0))
/PARK_LEFT: R710.1, U102.25 (PC2(ADC2))
/PARK_REAR: R709.1, U102.26 (PC3(ADC3))
/PARK_RIGHT: R711.1, U102.24 (PC1(ADC1))
/PARK_STATUS: R707.1, U102.27 (PC4(ADC4))
/RX_LED: R729.1, U105.13 (GPIO.1)
/SHIELD: C810.1, J506.0 (Shield), R727.2
/SHUTDOWN: SW301.1 (A), U103.6 (OUT)
/TRIM: R701.1, U101.4 (Trim)
/TX_LED: R730.1, U105.14 (GPIO.0)
/VBUS_DIV: R731.1, R732.2, U105.8 (VBUS)
GND: C802.2, C803.2, C805.2, C813.2, C814.2, C815.2, D601.1 (K), D602.1 (K), J502.3, J503.3, J504.3, J505.3, P601.4 (PGD), Q201.2 (S), Q202.2 (S), Q203.2 (S), Q204.2 (S), R701.2, R712.1, R713.1, R714.1, R715.1, R720.1, R721.1, R722.1, R723.1, U101.5 (-Vout), U102.0 (GND(PAD)), U102.3 (GND), U102.5 (GND), U102.21 (GND), U104.5 (GND), U106.9 (GND2), U106.15 (GND2), U107.2 (GND), Y901.2
GNDA: C801.2, C804.2, H1.1, H2.1, J501.3, R704.1, SW301.3 (C), U101.2 (-Vin), U103.1 (GND), U103.3 (GND), U103.5 (GND), U104.3 (C)
GNDD: C806.2, C807.2, C808.2, C809.2, C810.2, C812.2, D605.1 (A), J506.5 (GND), R727.1, R732.1, U105.2 (GND), U105.25 (GND), U106.2 (GND1), U106.8 (GND1)
unnamed: C801.1, F401.2, U101.1 (+Vin)
unnamed: C803.1, U102.20 (AREF)
unnamed: C811.2, U106.14 (B1)
unnamed: D601.2 (A), R706.2
unnamed: D602.2 (A), R707.2
unnamed: D603.1 (K), R729.2
unnamed: D604.1 (K), R730.2
unnamed: J502.2, R716.2, R720.2
unnamed: J503.2, R717.2, R721.2
unnamed: J504.2, R718.2, R722.2
unnamed: J505.2, R719.2, R723.2
unnamed: Q201.1 (G), R708.2, R712.2
unnamed: Q201.3 (D), R716.1
unnamed: Q202.1 (G), R709.2, R713.2
unnamed: Q202.3 (D), R717.1
unnamed: Q203.1 (G), R710.2, R714.2
unnamed: Q203.3 (D), R718.1
unnamed: Q204.1 (G), R711.2, R715.2
unnamed: Q204.3 (D), R719.1
unnamed: R703.1, R704.2, U103.4 (SENSE)
unnamed: R724.2, U104.2 (A)
unnamed: R728.2, U105.9 (~RSTb)
unnamed: U102.7 (PB6(XTAL1)), Y901.1
unnamed: U102.8 (PB7(XTAL2)), Y901.3
VBUS: C806.1, C807.1, D605.2 (K), J506.1 (VBUS), R731.2, U105.7 (VREGIN)
VDD: C808.1, C809.1, C812.1, D603.2 (A), D604.2 (A), R728.1, U105.5 (VIO), U105.6 (VDD), U106.1 (VDD1), U106.7 (EN1)

Notes on the sheet:
Voutnom | R1 | R2 | Ku | Vref 5VDC | 5k1Ω | 2kΩ | 2.5 | 2.5VDC | R1 x Vref | Rup =|---------------| - R2 | Voutset - Vref - Ku | | 5k1 x 2.5 | Rup =|---------------| - 2k | 5.25 - 2.5 - 2.5 | Rup = 49kΩ ~~ Closest E96 = 48k7Ω
>1/16W
(Active Low)
| R1 | Vmon(uv) = | 1 + ----| x Vit- | R2 | | 2M43| Vmon(uv) = | 1 + ----| x 394.5mV | 84k5 | Vmon(uv) = 11.739V
(POWER_STATUS)

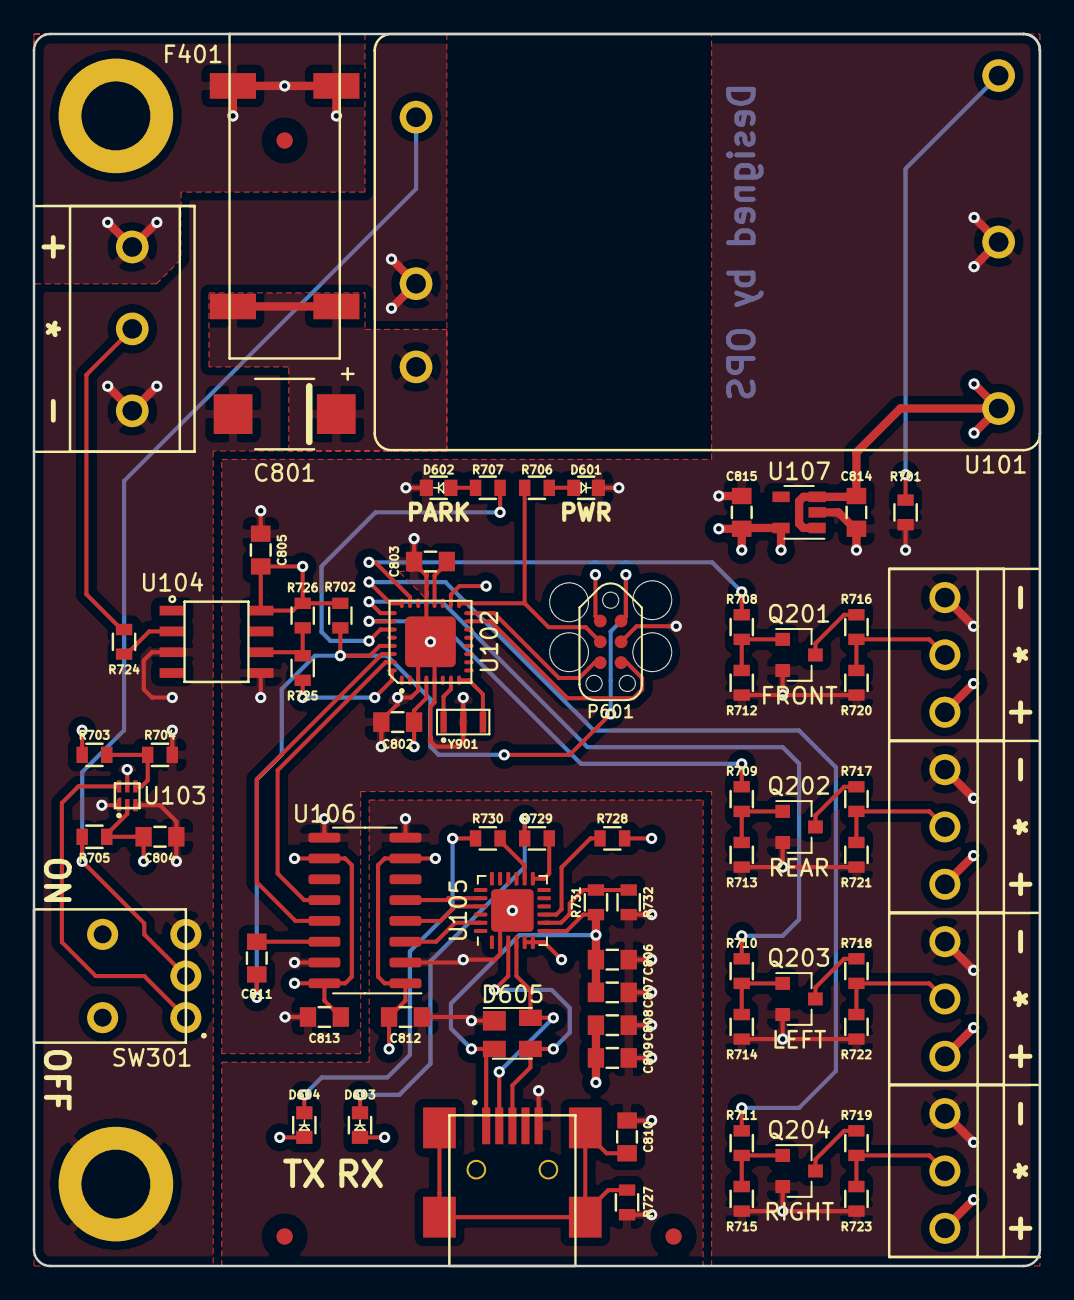
[picture p22: board VehicleAccessoryController.kicad_pcb from above]

Board: 4 copper layers, 61.4 x 75.2 mm, 78 parts (0 on the bottom side), 58 nets.

Other parts of the board:
fidr: FID; Fiducial
