EmbeddedDesign/VehicleAccessoryController/firmware/cp2102n/Linux_3.x.x_4.x.x_VCP_Driver_Source/cp210x_vehicle_accessory_controller/cp210x_vehicle_accessory_controller.mod.c

#include <linux/build-salt.h>
#include <linux/module.h>
#include <linux/vermagic.h>
#include <linux/compiler.h>

BUILD_SALT;

MODULE_INFO(vermagic, VERMAGIC_STRING);
MODULE_INFO(name, KBUILD_MODNAME);

__visible struct module __this_module
__attribute__((section(".gnu.linkonce.this_module"))) = {
	.name = KBUILD_MODNAME,
	.init = init_module,
#ifdef CONFIG_MODULE_UNLOAD
	.exit = cleanup_module,
#endif
	.arch = MODULE_ARCH_INIT,
};

#ifdef CONFIG_RETPOLINE
MODULE_INFO(retpoline, "Y");
#endif

static const char __module_depends[]
__used
__attribute__((section(".modinfo"))) =
"depends=usbserial";

MODULE_ALIAS("usb:vC0DEpBABEd*dc*dsc*dp*ic*isc*ip*in*");

MODULE_INFO(srcversion, "3D2994986483DFDF551581F");
