EmbeddedDesign/VehicleAccessoryController/(commit log)

2019-10-24 Schematic additions
    [ParkingModeCable_ReverseEngineering.sch, VehicleAccessoryController.sch, VehicleAccessoryController_BOM.ods]
2019-10-30 Schematic updates
    [VehicleAccessoryController.sch, VehicleAccessoryController_BOM.ods]
2019-11-08 add test board
    [VehicleAccessoryControllerTestBoard.kicad_pcb, VehicleAccessoryControllerTestBoard.sch, VehicleAccessoryControllerTestBoard_BOM.ods]
2019-11-15 test board layout
    [VehicleAccessoryControllerTestBoard-B_Cu.gbl, VehicleAccessoryControllerTestBoard-B_Mask.gbs, VehicleAccessoryControllerTestBoard-B_SilkS.gbo, VehicleAccessoryControllerTestBoard-Edge_Cuts.gm1, VehicleAccessoryControllerTestBoard-F_Cu.gtl, VehicleAccessoryControllerTestBoard-F_Mask.gts, VehicleAccessoryControllerTestBoard-F_Paste.gtp, VehicleAccessoryControllerTestBoard-F_SilkS.gto]
2019-11-16 test board schematic/layout updates, gerbers
    [VehicleAccessoryController.sch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]
2019-11-17 BOM update, change output connectors
    [VehicleAccessoryController.sch, VehicleAccessoryController_BOM.ods]
2019-11-20 schematic updates, begin layout
    [VehicleAccessoryController.kicad_pcb, VehicleAccessoryController.sch]
2019-11-22 test board PDFs, label updates, merge duplicates on BOMs
    [VehicleAccessoryController.kicad_pcb, VehicleAccessoryController.sch, VehicleAccessoryControllerTestBoard.kicad_pcb, VehicleAccessoryControllerTestBoard.sch, VehicleAccessoryControllerTestBoard_BOM.ods, VehicleAccessoryController_BOM.ods]
2019-11-23 updated required parts for test board list
2019-11-23 shcematic updates
    [VehicleAccessoryController.kicad_pcb, VehicleAccessoryController.sch, VehicleAccessoryController_BOM.ods]
2019-11-30 correct fuse holder, ACC pull-up, BOM Accessories, create firmware dir
    [VehicleAccessoryController.kicad_pcb, VehicleAccessoryController.sch, VehicleAccessoryControllerTestBoard.sch, VehicleAccessoryController_BOM.ods]
2019-11-30 adjust reference text size, fab notes
    [VehicleAccessoryController.kicad_pcb]
2019-12-01 test board code
2019-12-03 layout updates
    [VehicleAccessoryController.kicad_pcb]
2020-06-09 CAD models update
    [VehicleAccessoryController.kicad_pcb, VehicleAccessoryController_BOM.ods]
2020-06-13 CAD path update, add fuse CAD, add images
    [VehicleAccessoryController.kicad_pcb]
2020-06-14 BOM accessory updates
    [VehicleAccessoryController_BOM.ods]
2020-06-22 layout and cad updates
    [VehicleAccessoryController.kicad_pcb]
2020-06-23 layout and cad updates, add schematic pdf
    [VehicleAccessoryController.kicad_pcb, VehicleAccessoryController.sch]
2020-06-24 layout and firmware updates
    [VehicleAccessoryController.kicad_pcb, VehicleAccessoryController.sch]
2020-06-24 schematic/layout updates
    [VehicleAccessoryController.kicad_pcb, VehicleAccessoryController.sch]
2020-06-26 layout updates, gerbers
    [VehicleAccessoryController-B_Cu.gbl, VehicleAccessoryController-B_Mask.gbs, VehicleAccessoryController-B_SilkS.gbo, VehicleAccessoryController-Edge_Cuts.gm1, VehicleAccessoryController-F_Cu.gtl, VehicleAccessoryController-F_Mask.gts, VehicleAccessoryController-F_Paste.gtp, VehicleAccessoryController-F_SilkS.gto]
2020-06-28 layout updates, gerbers, pdfs
    [VehicleAccessoryController-B_Cu.gbl, VehicleAccessoryController-B_Mask.gbs, VehicleAccessoryController-B_SilkS.gbo, VehicleAccessoryController-Edge_Cuts.gm1, VehicleAccessoryController-F_Cu.gtl, VehicleAccessoryController-F_Mask.gts, VehicleAccessoryController-F_Paste.gtp, VehicleAccessoryController-F_SilkS.gto]
2020-07-04 CAD path update
    [VehicleAccessoryController.kicad_pcb]
2020-07-08 add custom cp2102n driver, directory cleanup
2020-07-08 update pdf, custom cp2102n driver code, avr updates
2020-07-10 store Strings in flash, Linux driver install instructions, directory cleanup
2020-07-10 add CAD image
