EmbeddedDesign/VehicleAccessoryController/(notices)

Notices in the files:
firmware/cp2102n/Linux_3.x.x_4.x.x_VCP_Driver_Source/cp210x_vehicle_accessory_controller/cp210x_vehicle_accessory_controller.c:
modify it under the terms of the GNU General Public License version
